andrescn20/tcu-629-documentacion/Imagenes/EnsambleInventor.png

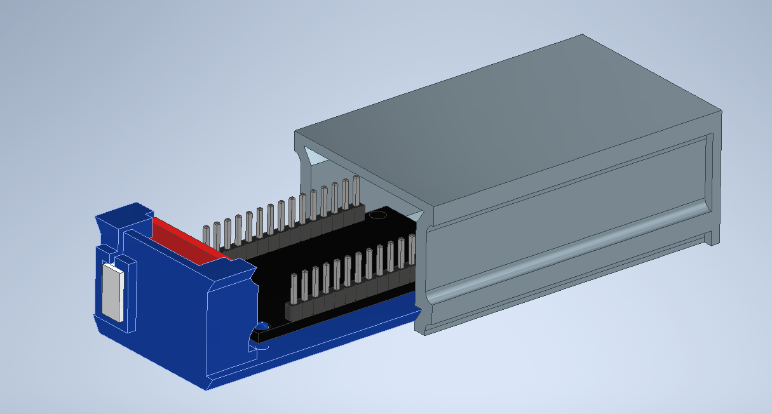
Imagenes/EnsambleInventor.png
