andrescn20/tcu-629-documentacion/Imagenes/DispositivoArmado.png

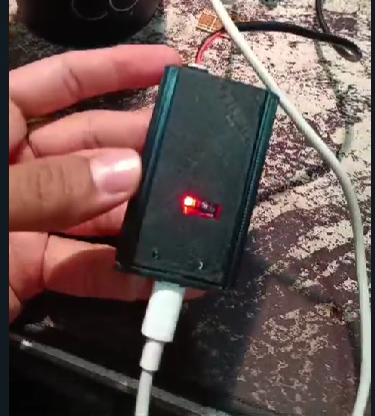
Imagenes/DispositivoArmado.png
