andrescn20/tcu-629-documentacion/Readme.txt

Este repositorio contiene toda la documentación referente al proyecto "Automatización de la monitorización de temperaturas de un calentador solar de agua." del TCU-629. 

Cada carpeta tiene su propio Readme donde se da una explicación de lo que se encuentra en dicha carpeta.
