andrescn20/tcu-629-documentacion/Código/Readme.txt

En esta carpeta se puede encontrar todo el código asociado a los dispositivos. 

Los archivos de Python son para hacer pruebas y verificar el funcionamiento de los dispositivos. Cada uno posee comentarios que explican su función. 

Los archivos de arduino son respectivamente para su uso en placas ESP32 o ARDUINO, según como lo indica el nombre de cada archivo. 

Cabe destacar que el código para arduino es para pruebas, ya que no posee lógica para conexión a wifi. 

El código para esp32 es el código que está utilizándose oficialmente en el proyecto.
