andrescn20/tcu-629-documentacion/Archivos Impresion 3D/Readme.txt

Los archivos en las carpetas están listos para impresión. 

La configuración suministrada es funcional y se probó en una impresora Creality Ender 3. 

La calidad utilizada es baja, ya que se trataban de pruebas de prototipado rápido. Es posible cambiar la configuración de los archivos para generar impresiones de mejor calidad.
