andrescn20/tcu-629-documentacion/Imagenes/Circuito_Placa.jpeg

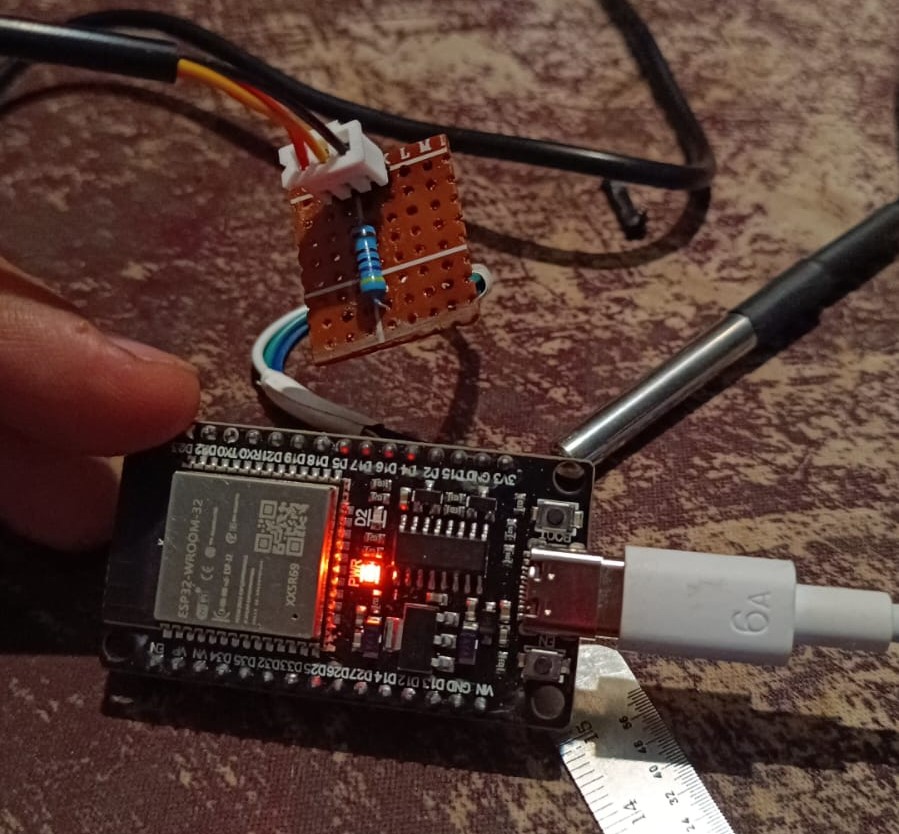
Imagenes/Circuito_Placa.jpeg
