andrescn20/tcu-629-documentacion/Imagenes/ConexionSensor.jpeg

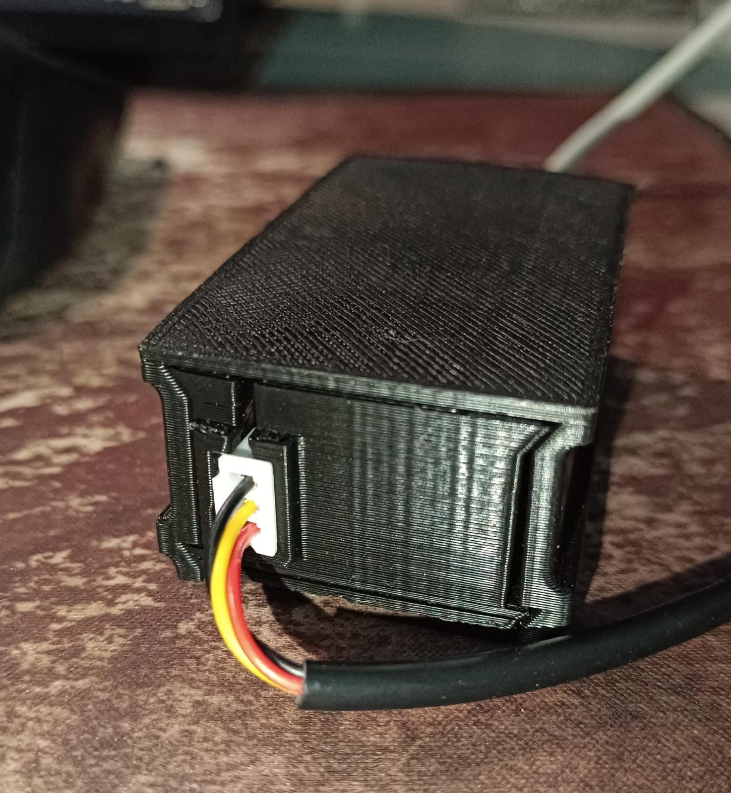
Imagenes/ConexionSensor.jpeg
