andrescn20/tcu-629-documentacion/Imagenes/PiezasDispositivo.jpeg

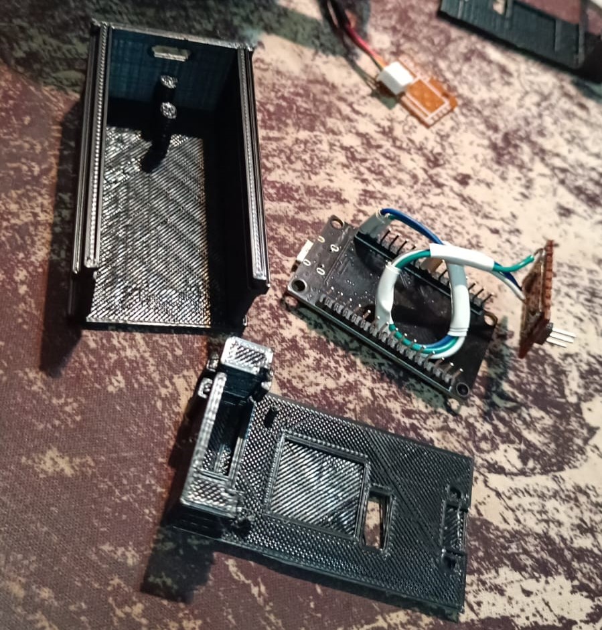
Imagenes/PiezasDispositivo.jpeg
