andrescn20/tcu-629-documentacion/Imagenes/PuertoSensor.jpeg

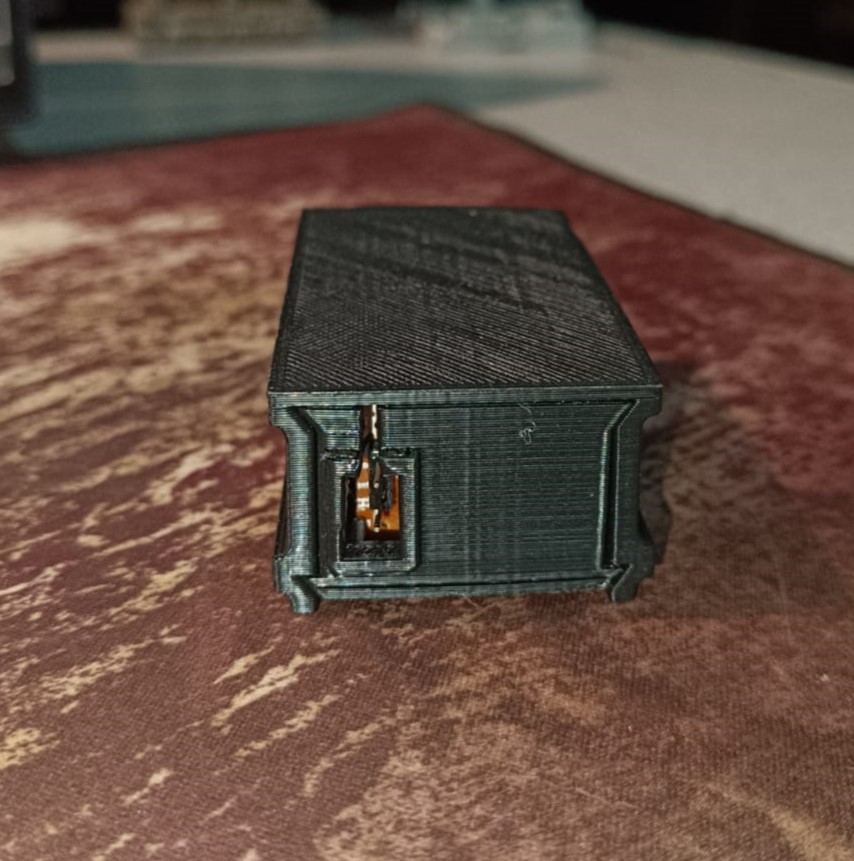
Imagenes/PuertoSensor.jpeg
