andrescn20/tcu-629-documentacion/Imagenes/PuertoUSB.jpeg

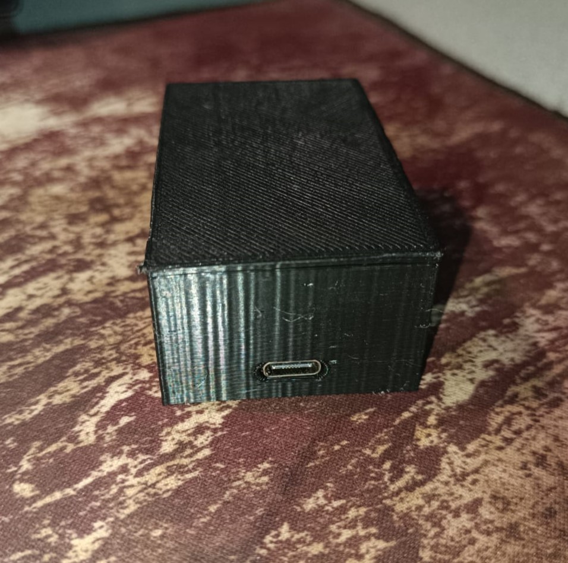
Imagenes/PuertoUSB.jpeg
