andrescn20/tcu-629-documentacion/Archivos Impresion 3D/EnsambleV2.stl

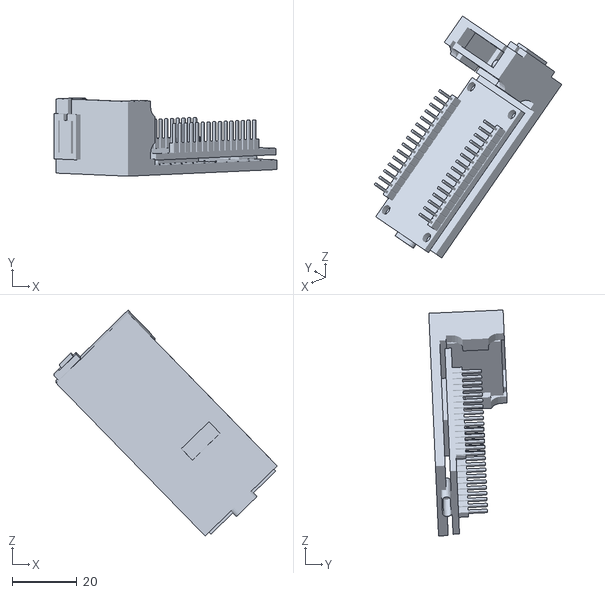
[picture p11: CAD file, 2024-09-08]
Archivos Impresion 3D/EnsambleV2.stl
68.9 x 24.2 x 69.9
