andrescn20/tcu-629-documentacion/Archivos Impresion 3D/PruebaBase.stl

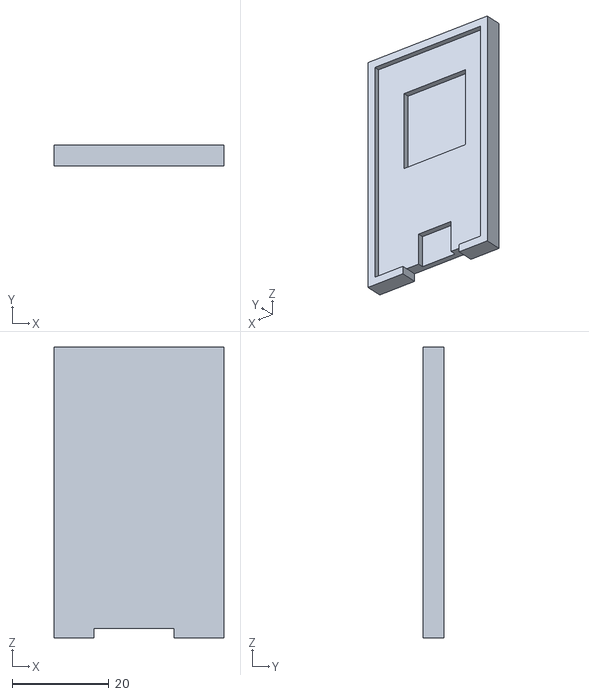
[picture p12: CAD file, 2024-09-08]
Archivos Impresion 3D/PruebaBase.stl
35.0 x 4.43 x 60.0
