andrescn20/tcu-629-documentacion/Archivos Impresion 3D/TapaCarcaza.stl

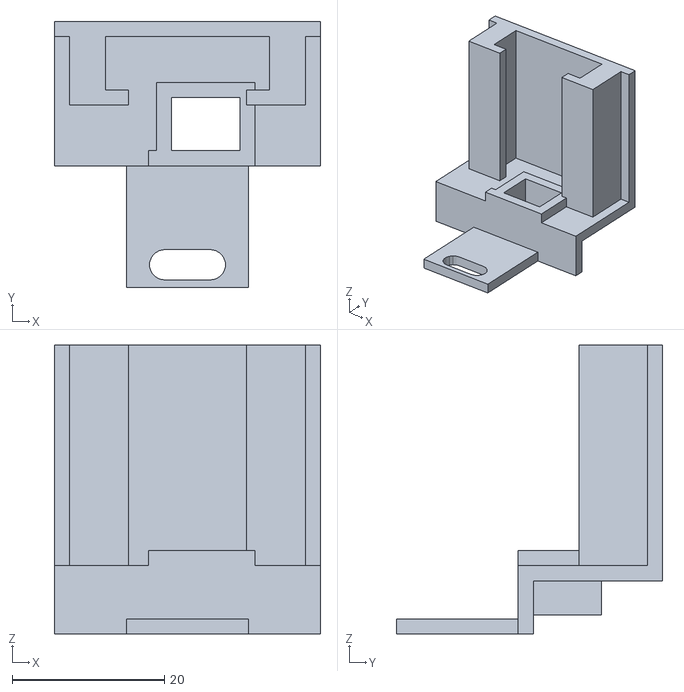
[picture p13: CAD file, 2024-09-08]
Archivos Impresion 3D/TapaCarcaza.stl
35.0 x 35.0 x 38.0
