andrescn20/tcu-629-documentacion/Archivos Impresion 3D/Carcaza.stl

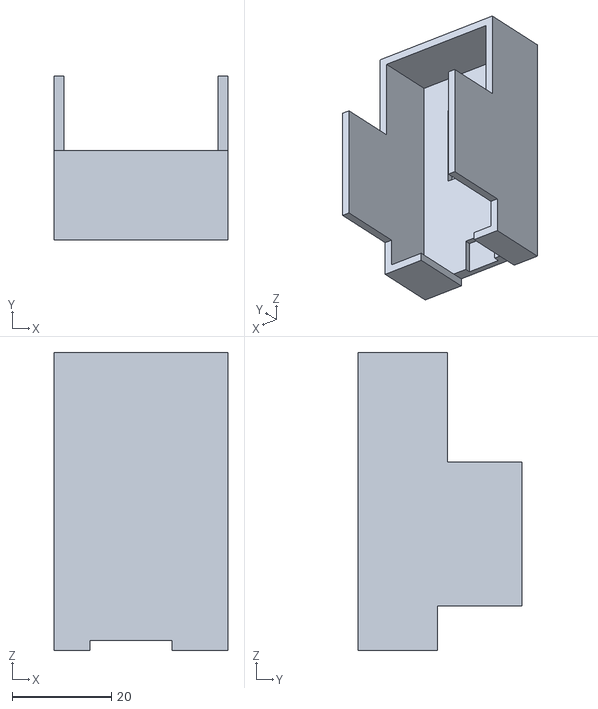
[picture p14: CAD file, 2024-09-08]
Archivos Impresion 3D/Carcaza.stl
35.0 x 33.0 x 60.0
