andrescn20/tcu-629-documentacion/Archivos Impresion 3D/TapaTrasera.stl

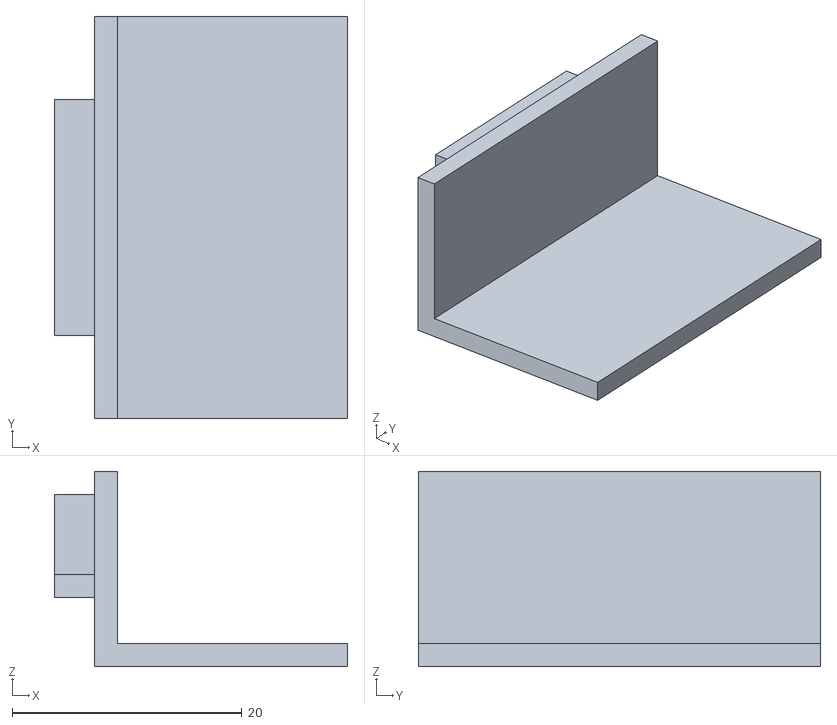
[picture p15: CAD file, 2024-09-08]
Archivos Impresion 3D/TapaTrasera.stl
25.5 x 35.0 x 17.0
