andrescn20/tcu-629-documentacion/Archivos Impresion 3D/CarcasaSuperiorV2.stl

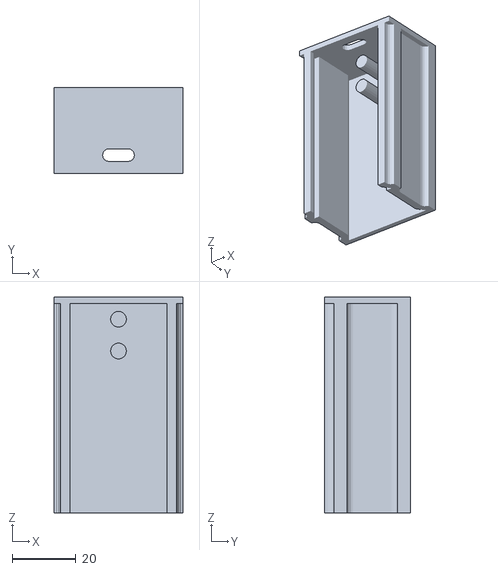
[picture p16: CAD file, 2024-09-08]
Archivos Impresion 3D/CarcasaSuperiorV2.stl
40.6 x 27.0 x 68.0
