andrescn20/tcu-629-documentacion/Archivos Impresion 3D/CarcazaV2.stl

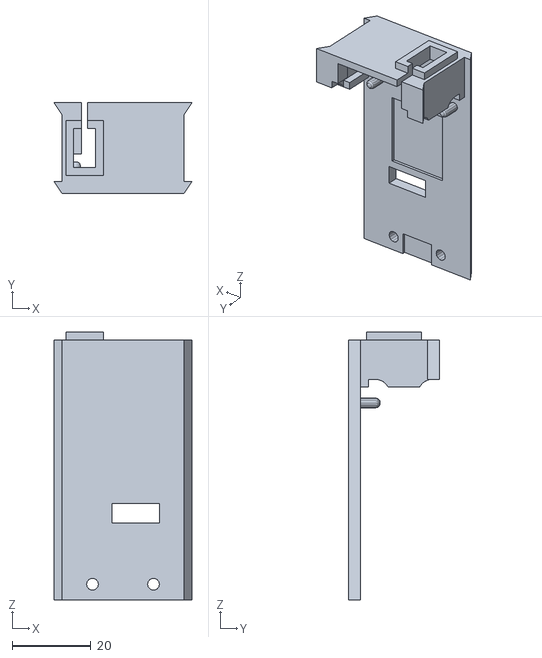
[picture p17: CAD file, 2024-09-08]
Archivos Impresion 3D/CarcazaV2.stl
35.0 x 23.0 x 68.0
