andrescn20/tcu-629-documentacion/(list of files, cad)

Other CAD files:
Sólidos Editables/ESP32_DevBoard.ipt
Sólidos Editables/VersiónFinal/CarcasaSuperiorV2.ipt
Sólidos Editables/VersiónFinal/CarcazaV2.ipt
Sólidos Editables/VersiónFinal/EnsambleV2.iam
Sólidos Editables/VersiónFinal/SecondCircuit.ipt
Sólidos Editables/VersiónFinal/SensorPin.ipt
Sólidos Editables/VersiónOriginal(Fallida)/CableFemale.ipt
Sólidos Editables/VersiónOriginal(Fallida)/Carcaza.ipt
Sólidos Editables/VersiónOriginal(Fallida)/Circuit.ipt
Sólidos Editables/VersiónOriginal(Fallida)/Ensamble.iam
Sólidos Editables/VersiónOriginal(Fallida)/TapaCarcaza.ipt
Sólidos Editables/VersiónOriginal(Fallida)/TapaTrasera.ipt
