andrescn20/tcu-629-documentacion/Imagenes/MontajeCarcasa.jpeg

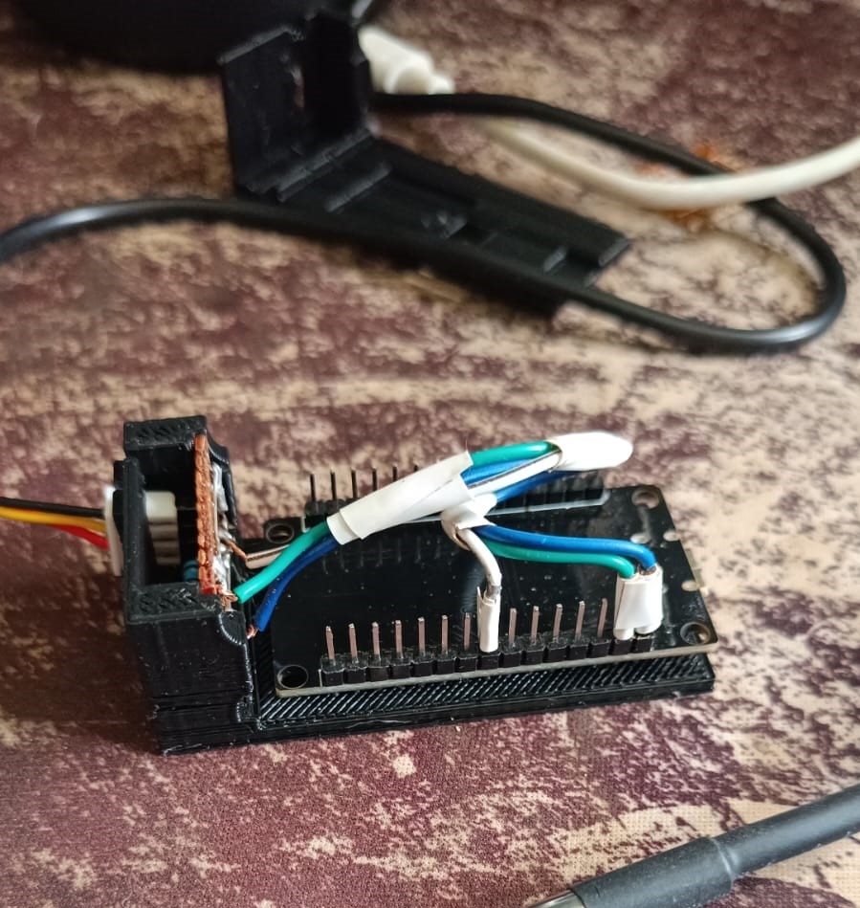
Imagenes/MontajeCarcasa.jpeg
