andrescn20/tcu-629-documentacion/Diagrama_DB_Actualizado.pdf

## DispenserLevelData Sensors

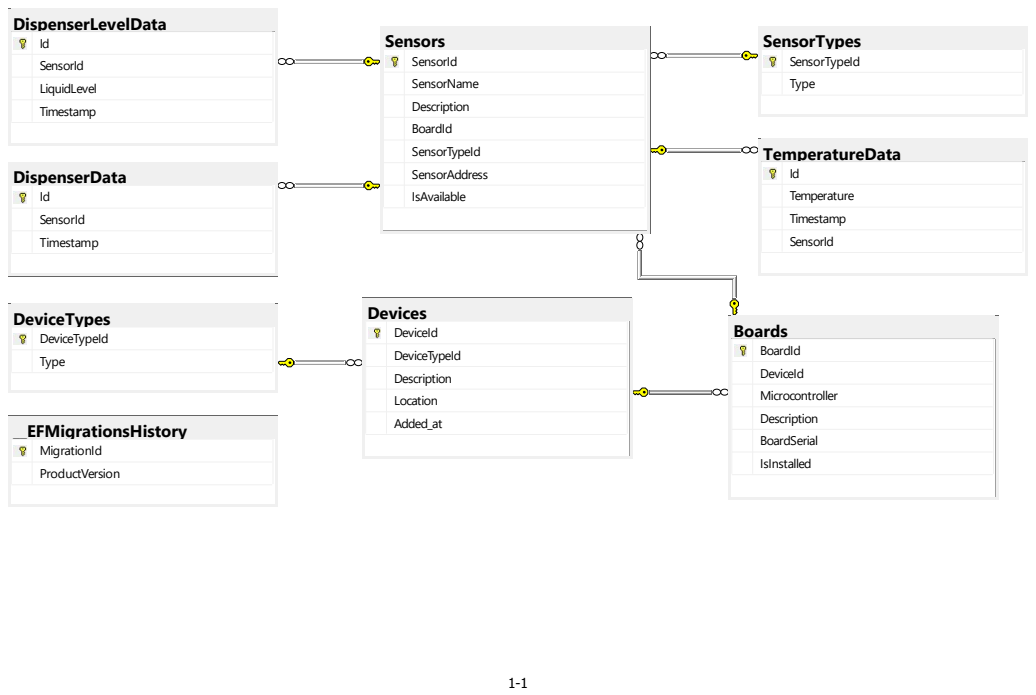
[picture p32: page 1]
__EFMigrationsHistory; Boards; Devices; DeviceTypes; DispenserData Id SensorId Timestamp; SensorId SensorName; SensorTypeId SensorAddress IsAvailable; SensorTypes SensorTypeId Type; TemperatureData Id Temperature Timestamp SensorId

Id
SensorId
LiquidLevel
Timestamp

Description
BoardId

DeviceId
DeviceTypeId
Location
Added_at

Type

Microcontroller
BoardSerial
IsInstalled

MigrationId
ProductVersion
