andrescn20/tcu-629-documentacion/(commit log)

2024-09-08 Initial Documentation Commit
    [CableFemale.0001.ipt, CableFemale.ipt, CarcasaSuperiorV2.0002.ipt, CarcasaSuperiorV2.ipt, CarcasaSuperiorV2.stl, Carcaza.0009.ipt, Carcaza.ipt, Carcaza.stl]
2024-09-08 Actualizar estructura de datos y agregar readme files.
    [CableFemale.0001.ipt, CableFemale.ipt, CarcasaSuperiorV2.0002.ipt, CarcasaSuperiorV2.ipt, Carcaza.0009.ipt, Carcaza.ipt, CarcazaV2.0007.ipt, CarcazaV2.ipt]
2024-09-16 Código para obtener identificador sensor
2024-09-16 Reacomodo de archivos
2024-09-16 Reacomodo de Códigos.
2024-09-16 Codigo para probar sensor
2024-09-16 Manual de Usuario
2024-09-16 Cambiar nombre de archivo docu
